ChrisV77/DewHeaterControllerArduino/(commit log)

2018-01-08 Add files via upload
    Current build of dew heater controller, 8 Jan 2018
2024-08-20 Create arduinoCode
2025-02-10 Add files via upload
    Added windows app which controls the Arduino Dew Heater
2025-02-24 updated instructions
    many changes - section links & 8.1 on PID. Still things to add/fix - highlighted in yellow
2025-02-24 add PID testing app
2025-02-25 added PID test apps-windows
